regnets/Lightduino/pictures/README.md

First fitting
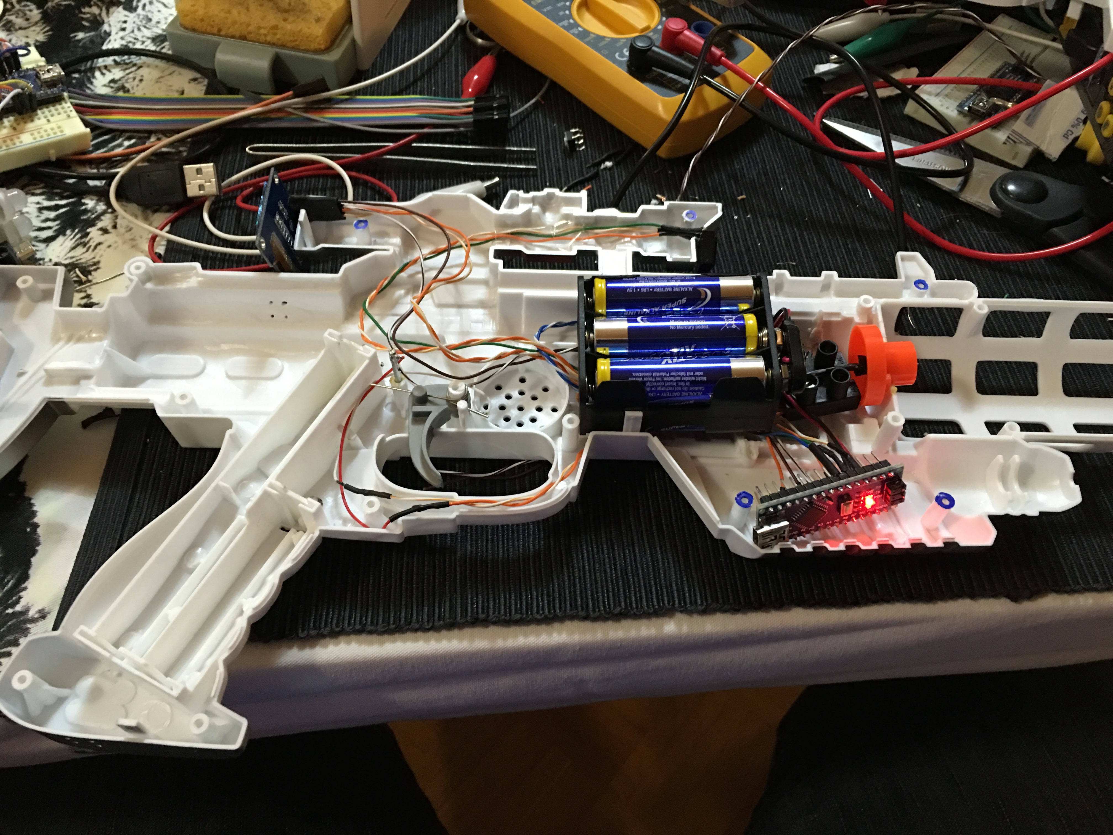
[picture p2: pictures/IMG_0444.JPG]
First fitting


1.3 OLED I2C Screen
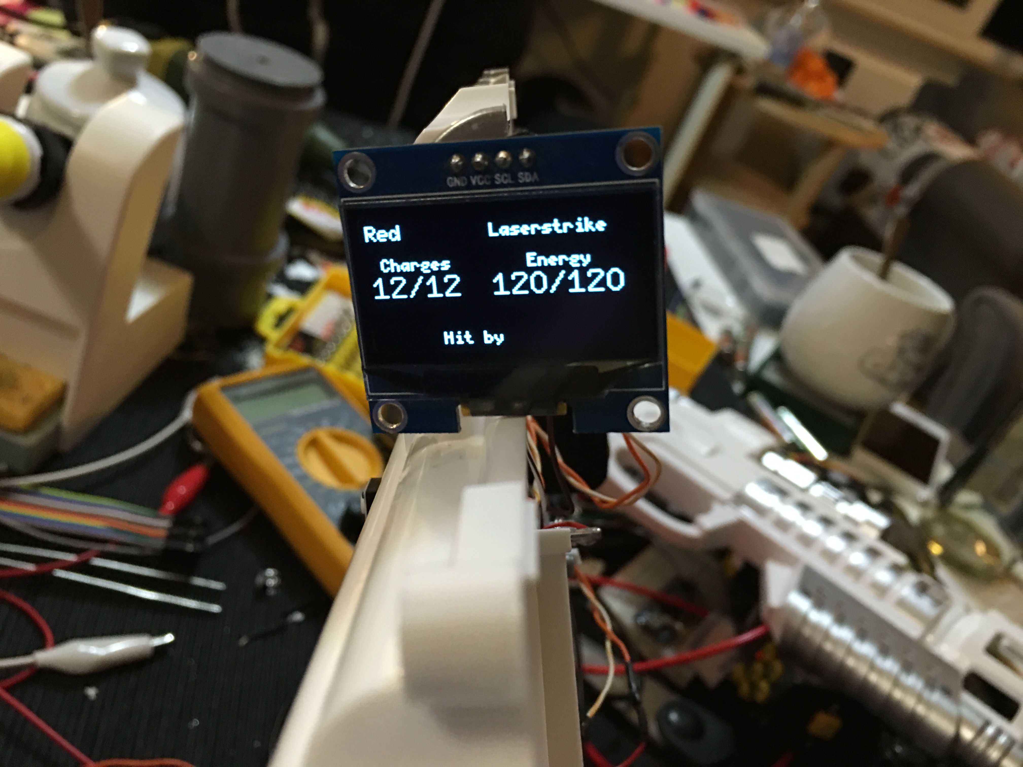
[picture p3: pictures/IMG_0445.JPG]
1.3 OLED I2C Screen


Cableing complete!
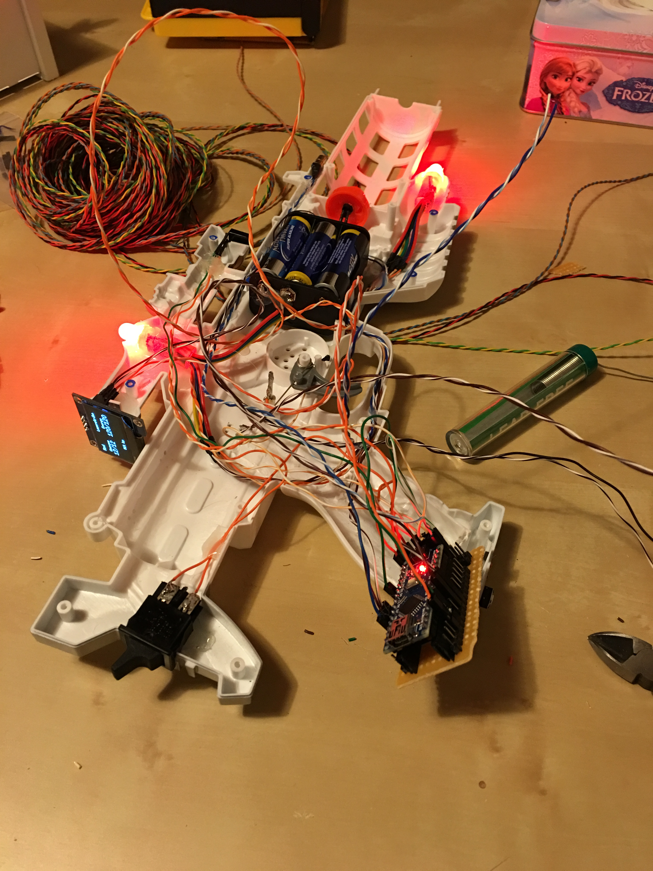
[picture p4: pictures/IMG_0548.JPG]
Cableing complete!


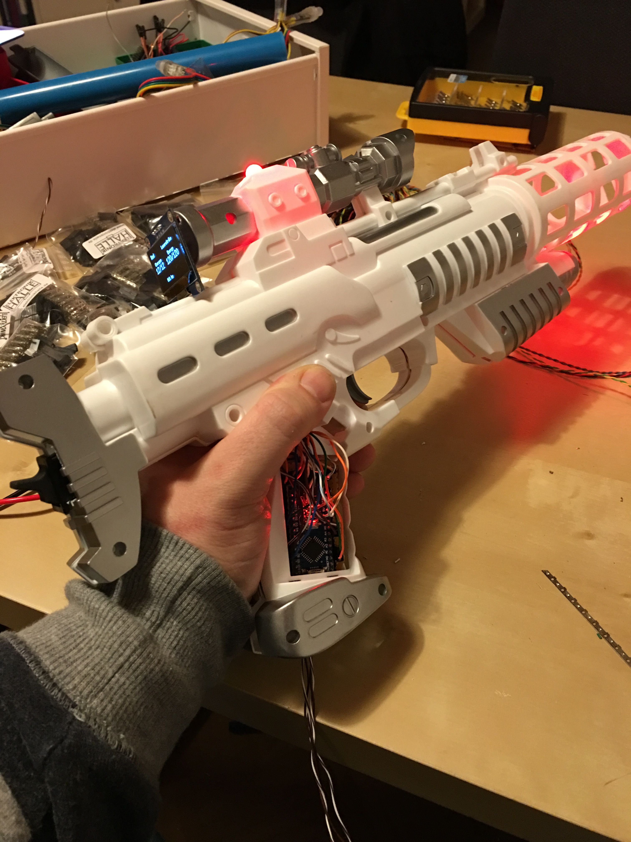
[picture p5: pictures/IMG_0549.JPG]


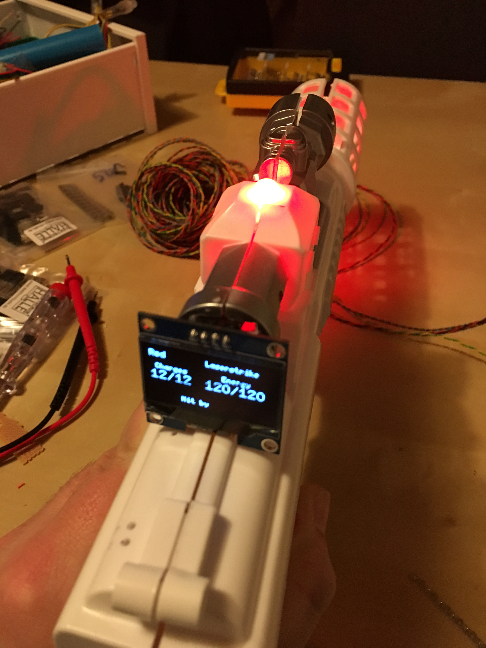
[picture p6: pictures/IMG_0550.JPG]




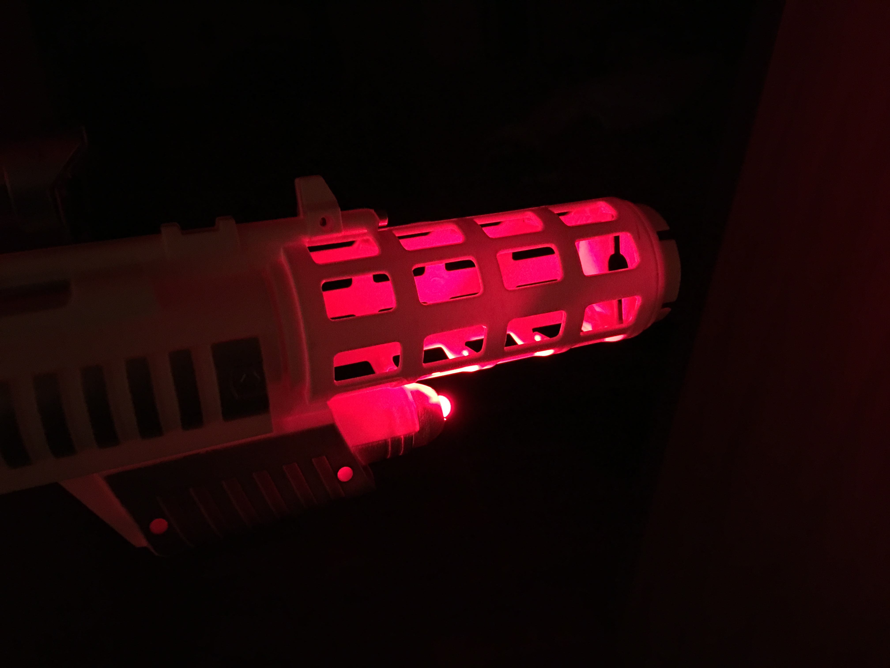
[picture p7: pictures/IMG_0554.JPG]


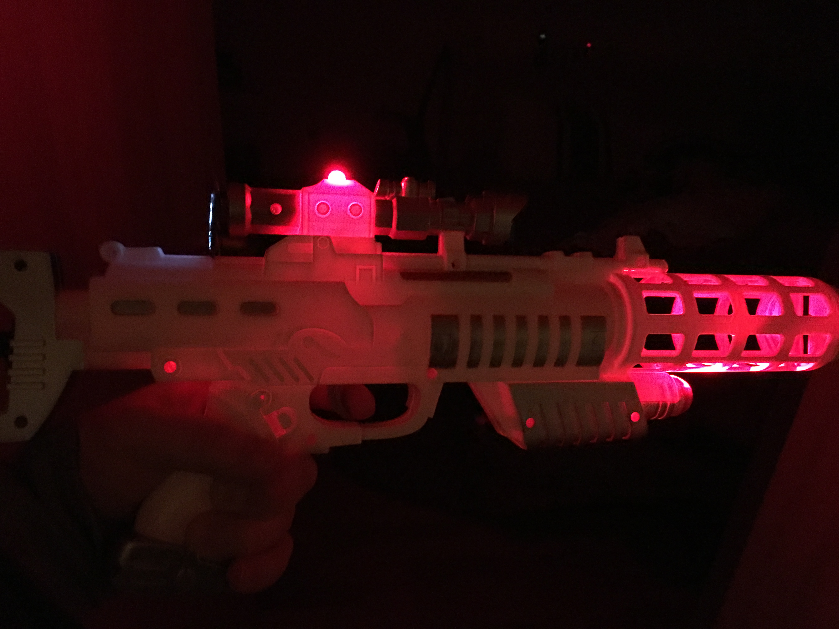
[picture p8: pictures/IMG_0556.JPG]
