regnets/Lightduino/schematics/Pewduino.png

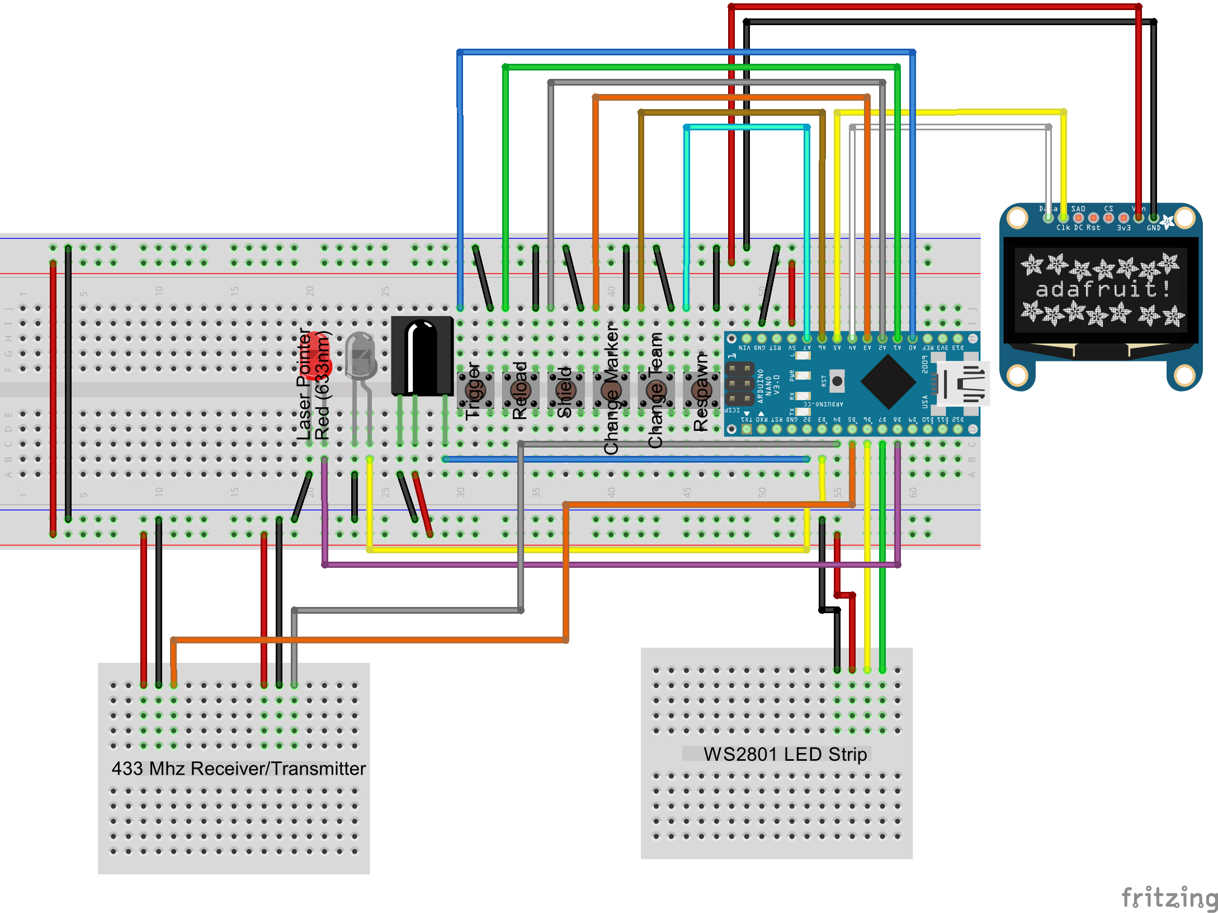
schematics/Pewduino.png
