regnets/Lightduino/(threads)

Thread 1 (2016-02-15):

Help reading your code

lhk, 2016-02-15:
I'm trying to create a project similar to yours and have strange problems with IRLib.
Apparently you have had issues with that library, too and managed to solve them: http://forum.arduino.cc/index.php?topic=290311.15

I read up on your code and have the following question:

You have defined constants for marks and spaces compatible to Lightstrike. With these definitions you use sendGeneric and decodeGeneric. But you pass different configurations to the sender and the receiver. On the sending side you use LIGHT_STRIKE_MARK_ONE and on the receiving side just 0.
How does that work, why is it necessary ?

I looked at your IRLib-light and it seems like sendGeneric and decodeGeneric are (almost) identical to the original versions.

I have described my problem in the forum post in more detail and would be very grateful if you could share some experiences.

regnets, 2016-02-16:
You are absolutely right.

I got the same issue as you and my first attempts. The solution is described in the comment above decodeGeneric in the original IRLib from cyborg5:
`/*
 * Again we use a generic routine because most protocols have the same basic structure. However we need to
 * indicate whether or not the protocol varies the length of the mark or the space to indicate a "0" or "1".
 * If "Mark_One" is zero. We assume that the length of the space varies. If "Mark_One" is not zero then
 * we assume that the length of Mark varies and the value passed as "Space_Zero" is ignored.
 * When using variable length Mark, assumes Head_Space==Space_One. If it doesn't, you need a specialized decoder.
 */`

If you don't pass 0 as MARK_ONE for the decodeGeneric method you will get a "head space error" i think and this will eventuate into a 0 for the result.

I also talked about this with cyborg5 but i can't rember on which plattform.

I think his response were that most ir protocols are working that way, but he would like to fix this in the future.

lhk, 2016-02-16:
Thanks for the quick response. I contacted cyborg5, too. The mark_one zero parameter was not my only problem. I passed the wrong rawcount, too.
I counted head mark and space = two samples . Mark and space for each bit = 2*numBits samples. And one space at the end.
That makes 2*numBits +3.
In fact there are 2*numBits +4 raw samples.

I checked against your code again. You transmit 32 bits of data with a rawcount of 66?
Strange. I tested with lots of different numBits, from 1 to 10. Anything different from the formula above fails.

regnets, 2016-02-16:
I thought it should be 66 Samples...

1. Undefined Space (wating for input)
2. HEADER_MARK_ONE
3. HEADER_MARK_ZERO
4.-65.<bits (32*2)>
66. Undefined Space.

lhk, 2016-02-16:
Well since it is working you must be right. There's no arguing with facts.
But the math doesn't add up. 65-3=62, 62/2=31
Your signal should only have space for 31 bits of data.

Maybe the last bit has no space, and the waiting for data is no sample ? Then you would have two more samples = 1 bit more for data.

However. With your help, my transmission works now. I passed 0 to the decoder, used the correct number of samples and it works.
Thank you very much.

Closed 2016-02-16.

Thread 2 (2016-02-16):

Sending and receiving at the same time

lhk, 2016-02-16:
In my setup I use two arduinos. One for sending, the other for receiving.
This means that I can detect hits even while firing.
The problem is: Communication between the two arduinos is not implemented yet. I would like to use a serial connection. But then the connection between arduino and PC is dropped = no debugging = programming nightmare.

I'm seriously doubting wether I can program this without debugging.
So I'm considering a one arduino solution.

At this point I encountered the problems with IRlib, searched online, found your project and read up on the code. You use only one arduino, right ?
Does that work for you ?

66 samples per signal, let's say an average of 1000 per mark and space. I believe that this number is a multiple of the carrier frequency. So 38kHz times 66000. That's about two seconds per signal. That surely can't be right.

Did you ever experience "invulnerability" while shooting ?
Did you experiment with burst fire modes (they should make it even worse) ?

regnets, 2016-02-17:
I am using a one arduino solution, however you will be invulnerable while you are sending data.

However the whole transmission is not two secondes long. You can calculate how long your signal is.

For this calculation you don't need the frequency as this is just the frequency band and not the real up and down (or high and lows) in your signal.

You could use the irlib debug method to see how (timely) long your signal is.

In my case i think i got 900µs for every mark and space with a header of 6750µs (just as example).

So i need 66 raw samples where 63 (remember the first and last are undefined long) are about 900µs and the header mark is about 6750µs so this will add up to 63,2 ms.

I used this formula: (63 * 900 µs) + (6750 µs) = 63.45 ms.

I hope this is correct.

However my arduino has to update the display every time a displayvalue changes and this takes about 170ms which is way too long.

For the invulnerability problem while sending, the irlib uses an interupt which triggers the receiving code in the library and you can do the same for the trigger button (the arduino uno/nano has two interrupts). So your arduino should be able to receive a signal, send a signal and display something.

We didn't experience invulnerability, because we aren't ready to play with the Lightduino Guns, currently we are testing different lenses and voltages for the ir led as the homemade Lightstrike Guns are much more powerful and will hit the Lightstrike weapons just with the reflections of the ir light. Then we will need to build a calibration station. So that the laser pointer will point to the exact same spot as the ir led and the ir led should not be that powerful that the reflections of the ir light will trigger the hit sensor on the original weapons.

As you can thee in the Lightduino Sketch all weapon modes got a delay, so there is no burst mode. The fastet weapon mode is able to send a signal every 175ms (if you release the trigger in the meantime).

´code, type, enabled, name, damage, charges, bounceDelay, continuesDelay, reloadTime
´ { 0x0102, 'P', true,  "Laserstrike",    -10, 12,  175,  250, 1750 },

lhk, 2016-02-19:
Very interesting information, thanks

Closed 2016-02-19.
