regnets/Lightduino/(commit log)

2015-12-29 Massive Changes
    New values for marker bounce and continues delay.
    Changed marker charges.
    Added pistol display for infinite ammo (just two 'o')
    Added waittime for some actions (reload, team change, marker change)
    Removed libraries for 433 mhz communication
    Temporarily switched to standard irlib instead of irlib-light
    Added "Hit by <someone>" to display output
2016-01-03 Better Button Handling
    The button handling is now centralized in two functions (setupButtons,
    evaluateButtons). So the main loop doesn't get crowded with low level
    stuff.
2016-01-09 Pictures of the first prototype added
    Pictures of the first prototype added
2016-01-09 Changed Bouncedelay for button repeat.
    Changed Bouncedelay for button repeat.
